DStageGarage/ABS2SPEED/A2S_v3.1/DStage_A2S_v3.1_schematic.png

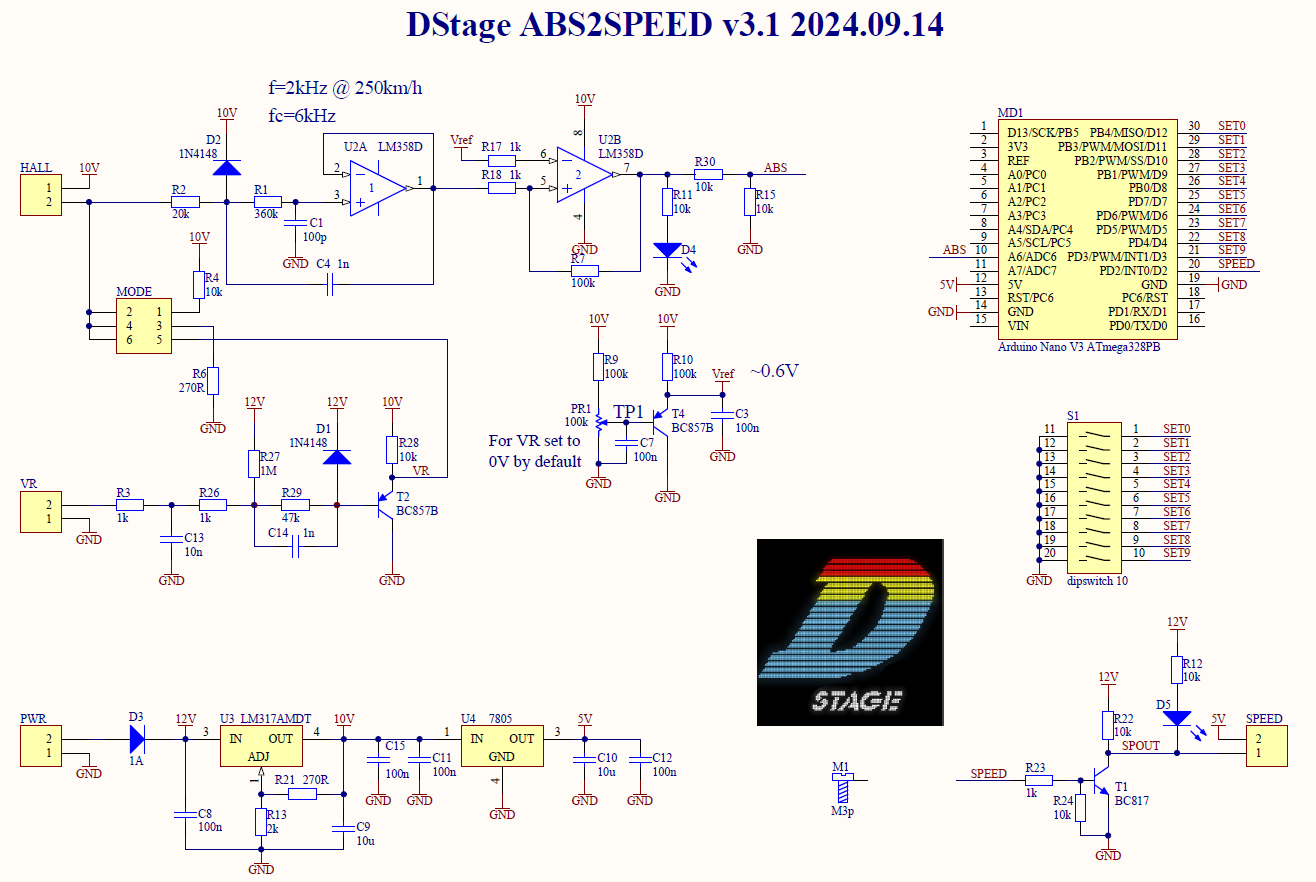
A2S_v3.1/DStage_A2S_v3.1_schematic.png
