DStageGarage/ABS2SPEED/A2S_v3.1/DStage_A2S_v3.1_BOM.xlsx

Comment | Designator | Footprint | JLCPCB part #
RB521S30T1G | D1-2 | 0805 | C167133
M7 | D3 | SMB | C95872
LED GREEN | D4-5 | 0805 | C2297
S8550 | T2,T4 | SOT-23 | C105432
S8050 | T1 | SOT-23 | C2146
LM358 | U2 | SO14 | C7950
LM317AMDT | U3 | D-Pak | C77880
MC7805BDTG | U4 | D-Pak | C83632
2.2k | R13 | R0805 | C17520
1kΩ | R3,R17-18,R23,R26 | R0805 | C17513
300R | R6,R21 | R0805 | C17617
10k | R4,R11-12,R15,R22,R24,R28,R30 | R0805 | C17414
20k | R2 | R0805 | C4328
100k | R7,R9-10 | R0805 | C149504
330k | R1 | R0805 | C17629
51k | R29 | R0805 | C17737
1M | R27 | R0805 | C17514
100k | PR1 | SMD-3_3.0x3.8x1.2 | C128545
1nF | C4,C14 | C0805 | C46653
100nF | C3,C7-8,C11-12,C15 | C0805 | C28233
10n | C13 | C0805 | C1710
100pF | C1 | C0805 | C1790
4.7uF | C9-10 | C0805 | C1779
screw terminal |  | 5mm | C474881
