DStageGarage/ABS2SPEED/(commit log)

2024-09-27 Added v3.1 HW files
    [DStage_A2S_v3.1_BOM.xlsx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]
2024-09-27 added schematic
2024-09-28 photos of the prototype
2024-10-12 corrections for glitches and staging
    Some small changes that seem to help to put speedo to 0 in abnormal situations like disconnection of the speed sensor, perhaps also smoother for normal low/0 speed.
    Also small change for staging, I had a report that it didn't work before but I haven't checked. For sure it should work now.
    [A2S.ino]
